CodeNova-X/BUZZIN/images/Battery.png

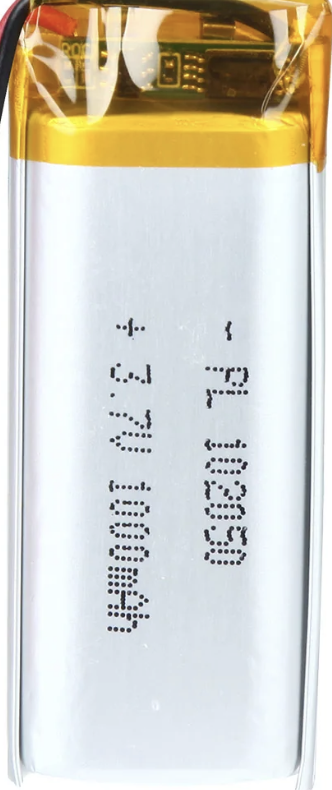
images/Battery.png
