CodeNova-X/BUZZIN/images/Controller.png

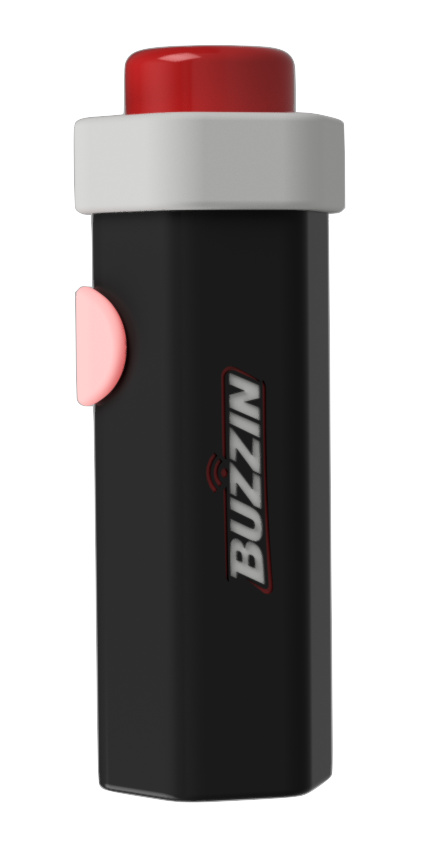
images/Controller.png
