CodeNova-X/BUZZIN/images/PCB.png

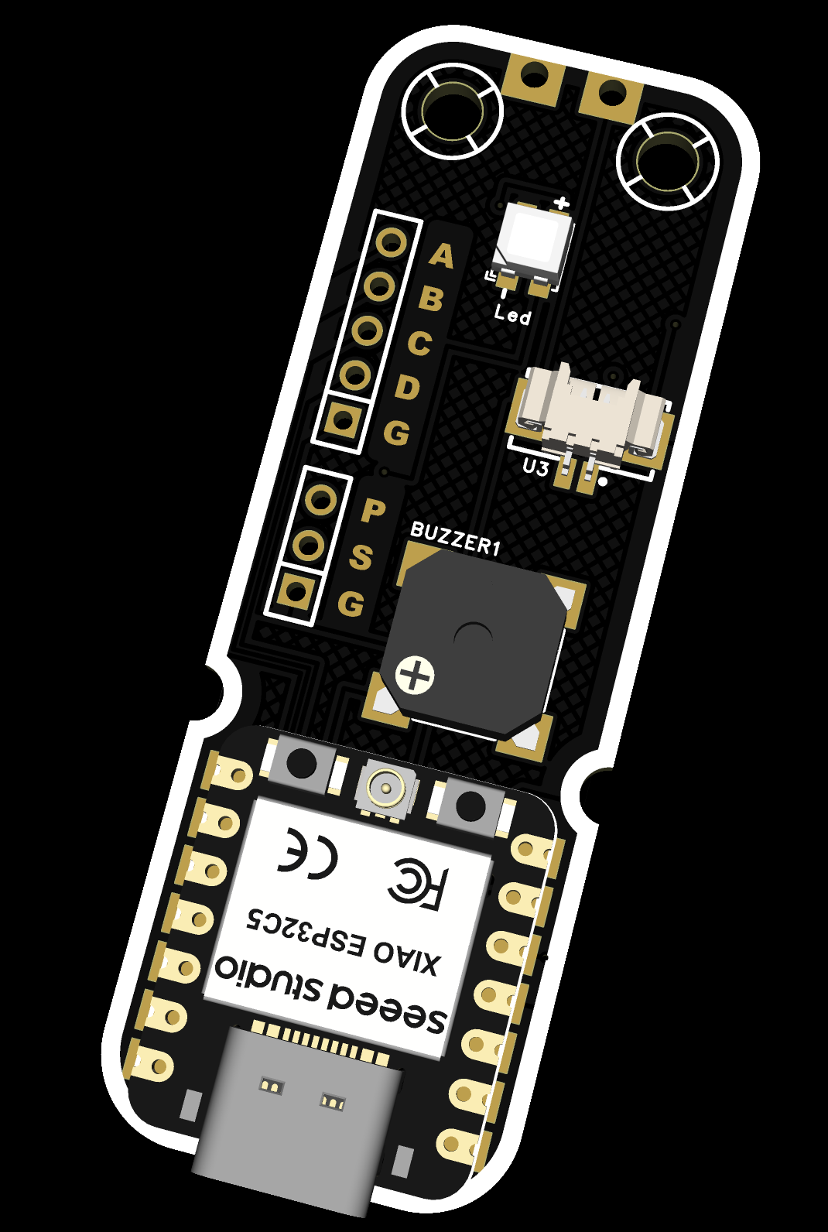
images/PCB.png
