CodeNova-X/BUZZIN/images/Schematic.png

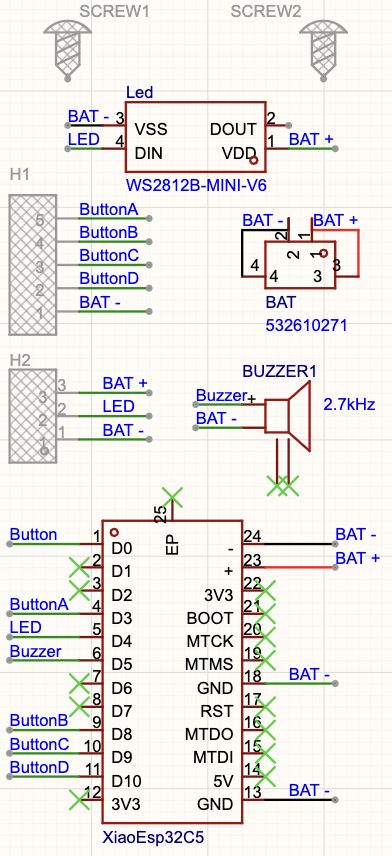
images/Schematic.png
