CodeNova-X/BUZZIN/3D-models/BUZZIN-V1.5-HUB.step

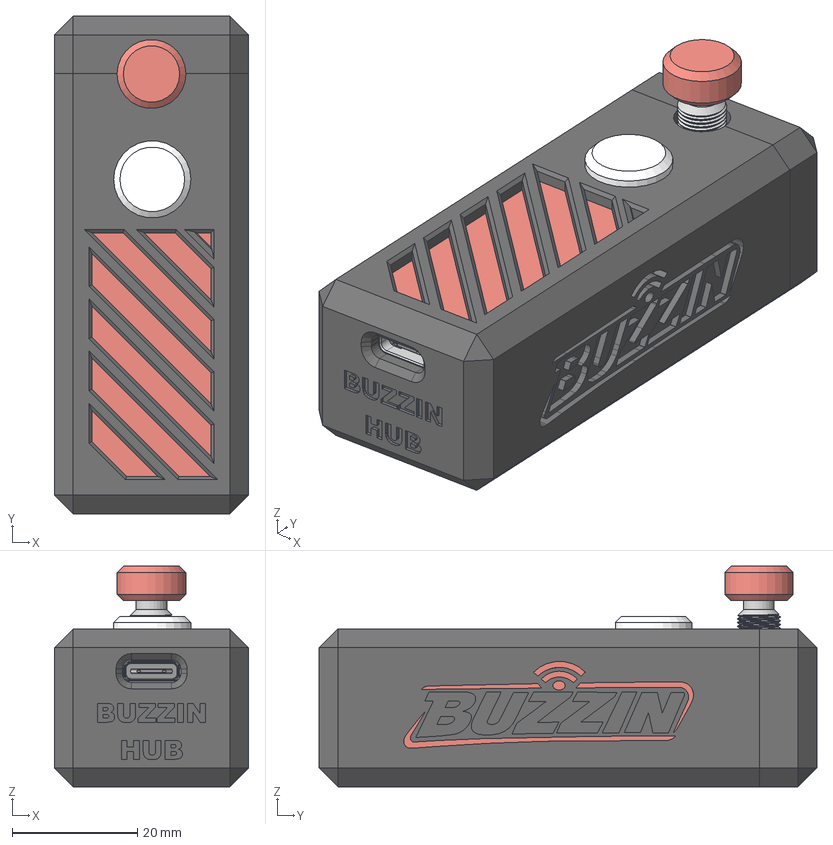
[picture p5: CAD file, 2026-11-08]
3D-models/BUZZIN-V1.5-HUB.step
31.0 x 79.5 x 35.2 mm
