CodeNova-X/BUZZIN/3D-models/BUZZIN-V1.5_PCB_model.step

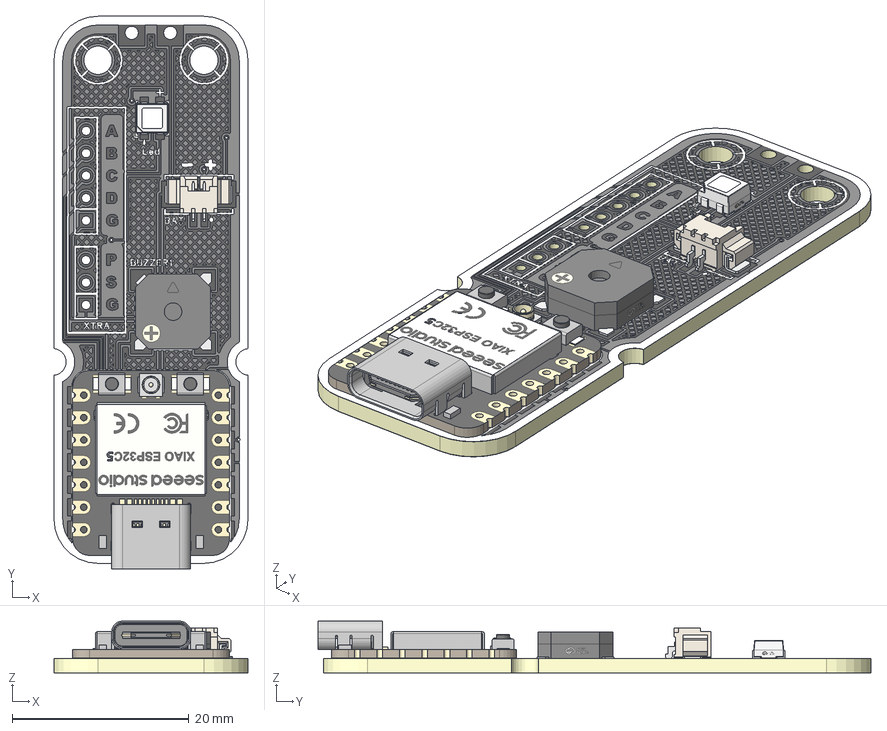
[picture p6: CAD file, 2026-11-01]
3D-models/BUZZIN-V1.5_PCB_model.step
22.0 x 62.6 x 5.88 mm
Board~D2yP
TopCopper~D2yP x 49
BottomCopper~D2yP x 22
TopSilkscreen~D2yP x 52
BottomSilkscreen~D2yP x 6
TopFpcStiffener~D2yP
BottomFpcStiffener~D2yP
COMM-SMD_XIAO-ESP32-C5~Seeed Studio XIAO ESP32-C5.step~6TdB x 29
CONN-SMD_532610271~CONN-SMD_532610271~Jace
BUZ-SMD_4P-L8.5-W8.5-P8.50-BR~BUZ-SMD_4P-L8.5-W8.5-H3.0~60jC
LED-SMD_4P-L3.5-W3.5-TL_WS2812B~LED3535-4P_L3.5-W3.5-H1.9-LS3.7~Ssds
