CodeNova-X/BUZZIN/3D-models/BUZZIN-V1.5.step

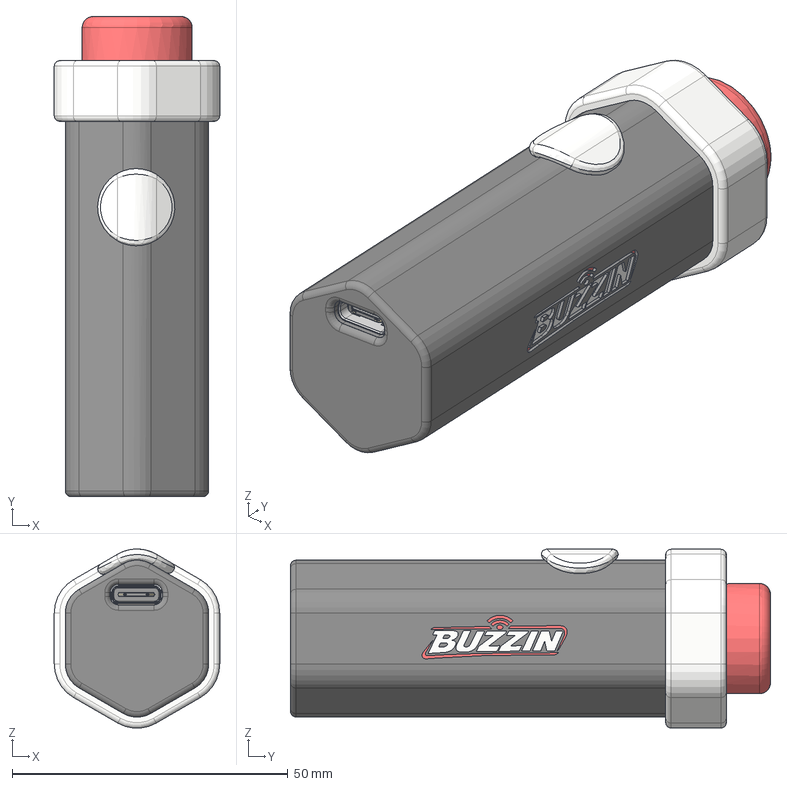
[picture p7: CAD file, 2026-10-31]
3D-models/BUZZIN-V1.5.step
30.0 x 87.0 x 32.4 mm
