CodeNova-X/BUZZIN/(list of files, cad)

Other CAD files:
3D-models/BUZZIN-V1.5-HUB.f3d
3D-models/BUZZIN-V1.5.f3d
