CodeNova-X/BUZZIN/(commit log)

2026-10-31 Rename Vintage BUZZIN Wireless Buzzer Poster.png to BUZZIN Poster.png
2026-10-31 Add files via upload
    step version of the cad file
    [BUZZIN-V1-Case.step]
2026-10-31 Enhance README with images and project details
    Added images and sections for schematic, PCB, and model render.
2026-10-31 Update README with detailed project description
    Revised project description to clarify features and design inspirations, including details about the ESP32 components and customization options.
2026-10-31 Delete BUZZIN-V1-Case.step
    older version
    [BUZZIN-V1-Case.step]
2026-10-31 Update README with versioned schematic and PCB sections
2026-10-31 Add step file
    [BUZZIN-V1.5.step]
2026-10-31 Add schematic and PCB V1.5 section to README
2026-10-31 Revise README with updated PCB images and details
    Updated images and descriptions for PCB versions. Added details about the V1.5 design improvements and expansion capabilities.
2026-10-31 Fix image tags in README for V1 schematic
    Updated image tags for schematic and PCB V1.
2026-10-31 Adjust image dimensions in README.md
    Updated image sizes for schematic and PCB V1 section.
2026-10-31 Update README with images for V1 schematic and PCB
    Added images for Schematic and PCB V1 section.
2026-11-01 Add BOM for single controller components
    Added a BOM section with components and links.
2026-11-08 Add BOM
    [BUZZIN-BOM.csv]
2026-11-08 Remove BOM section from README
    Removed BOM section detailing components and their links.
2026-11-08 Organized files into folders and added images
    [BUZZIN-BOM.csv, BUZZIN-V1.5.f3d, BUZZIN-V1.5.step, BUZZIN-V1.5_PCB_model.step]
2026-11-08 Add step file for hub
    [BUZZIN-V1.5-HUB.step]
2026-11-09 Revise README with project details and specifications
    Updated the README to provide a detailed introduction and specifications for the BUZZIN wireless game buzzer project, including information about the controllers and hub design.
2026-11-09 Add BOM and pricing details to README
    Added Bill of Materials (BOM) and pricing details for the BUZZIN project, including components, shipping, taxes, and final pricing.
2026-11-09 Refactor BUZZIN BOM to Markdown format
    Updated the BOM format for BUZZIN project to Markdown style, including detailed sections for components, shipping, taxes, and final pricing.
    [BUZZIN-BOM.csv]
2026-11-09 Update BOM for BUZZIN with detailed pricing
    [BUZZIN-BOM.csv]
2026-11-09 Change 'Total Price' to 'Total' in BOM table
    Updated the total price column header in BOM section.
2026-11-09 Update BOM with supplier links and notes
2026-11-09 Update BOM table headers for clarity
2026-11-09 Refine BOM table and final pricing format
    Updated the BOM table to improve clarity and adjusted final pricing terminology.
2026-11-09 Revise BOM and pricing details in README
2026-11-11 Revise BOM section for BUZZIN project
    Updated BOM section for BUZZIN project with detailed components and costs.
